ftobler/bldc-servo/README.md

# BLDC Servo

Custom PCB with BLDC controller for a Servo.

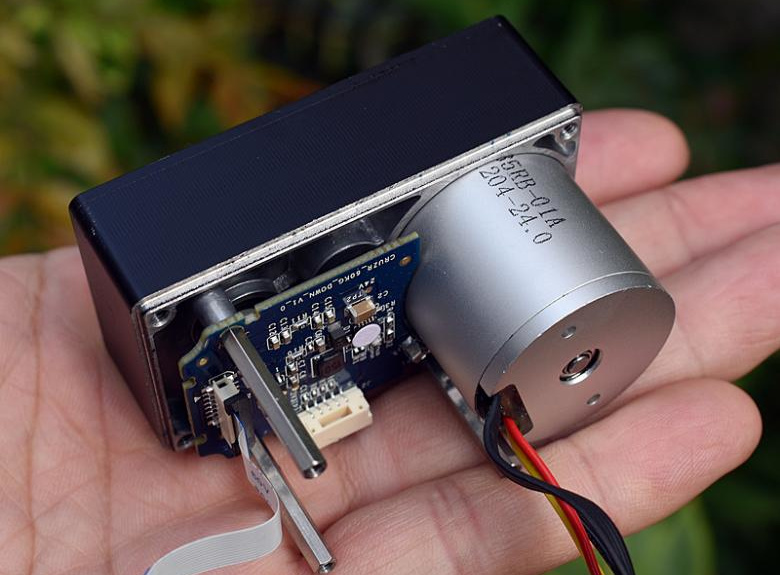
[picture p1: datasheet/aliexpress-Robot-precision-high-torque-60KG-bus-servo.jpg]
busservo
