ftobler/bldc-servo/datasheet/2835RB-motor-datasheet.jpg

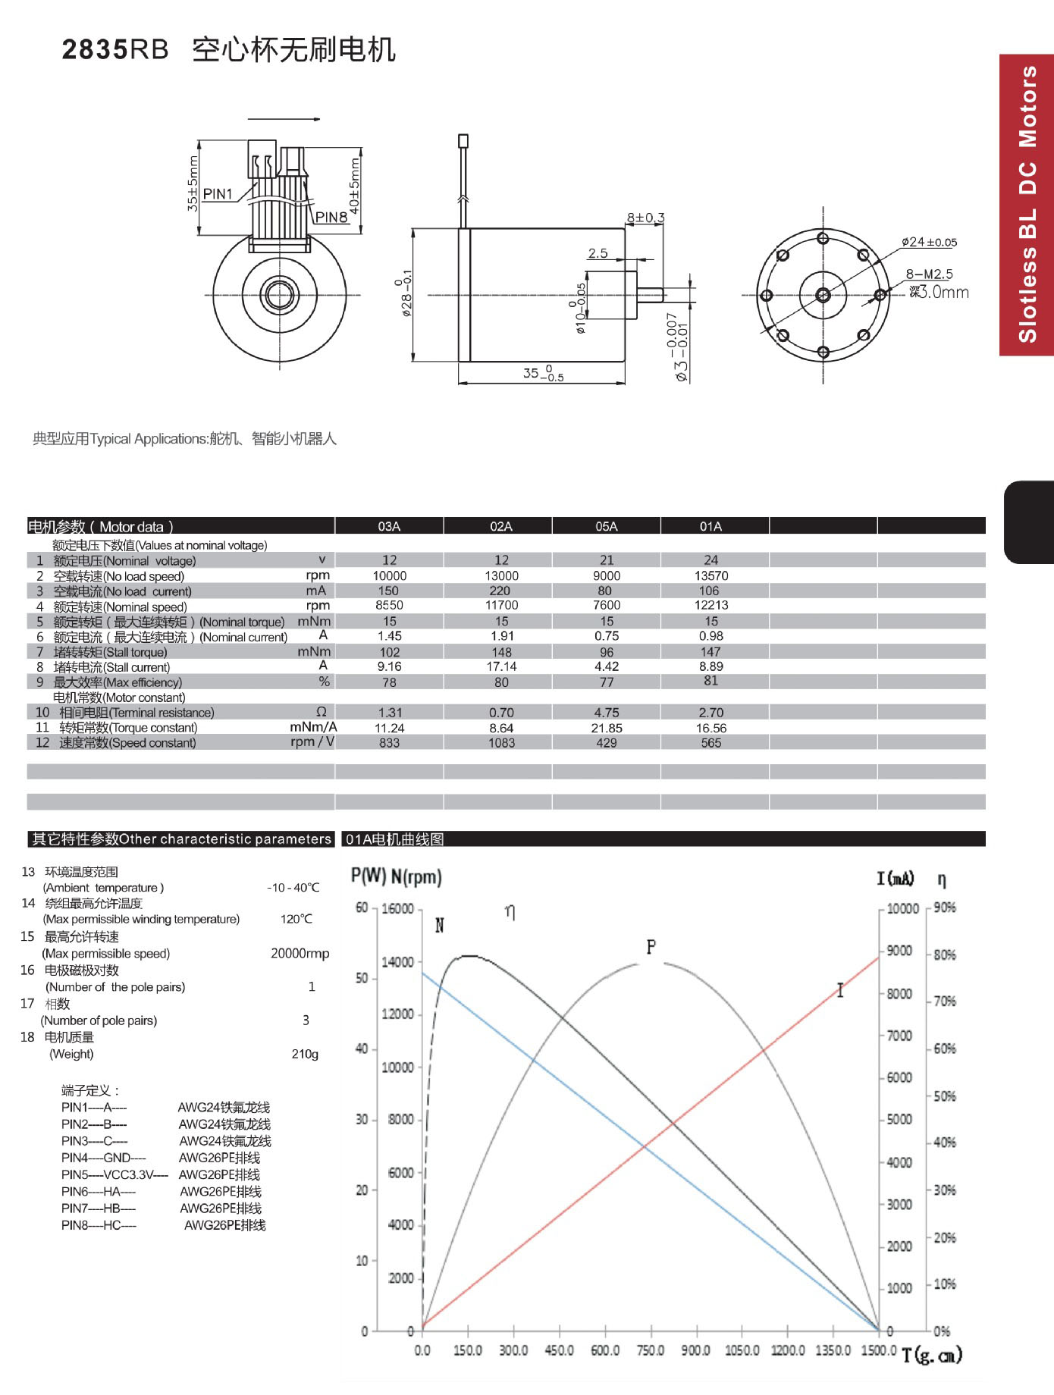
datasheet/2835RB-motor-datasheet.jpg
