ftobler/bldc-servo/datasheet/2835RB-motor.jpg

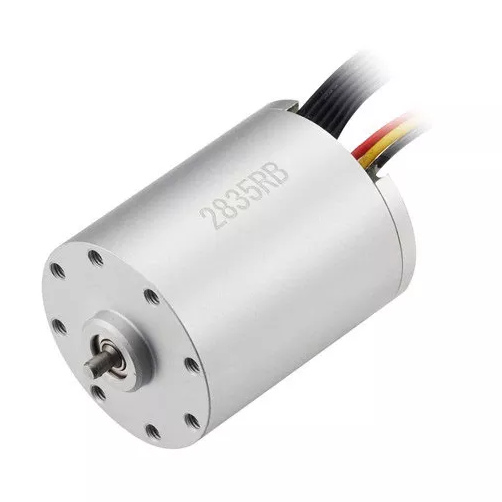
datasheet/2835RB-motor.jpg
