ftobler/bldc-servo/datasheet/bus-servo-bottom-pcb-projection.jpg

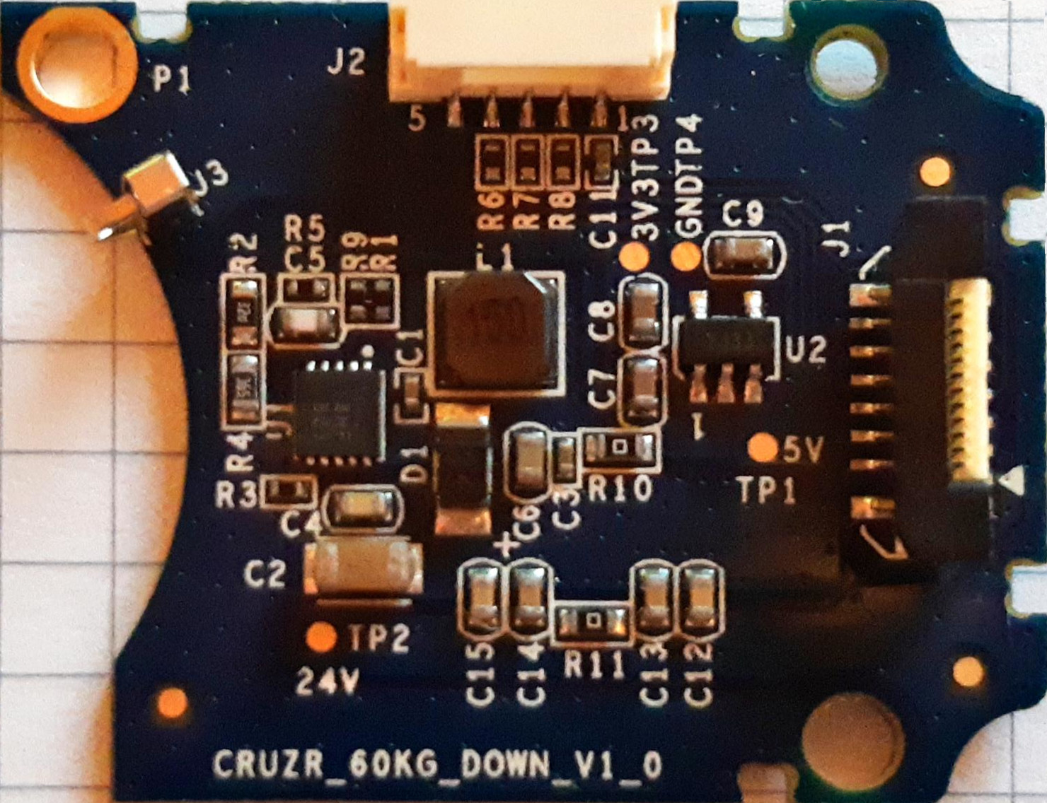
datasheet/bus-servo-bottom-pcb-projection.jpg
