ftobler/bldc-servo/datasheet/images_original_product/v2-01ab3820fb37335d740b385a8f822a2c_r.jpg

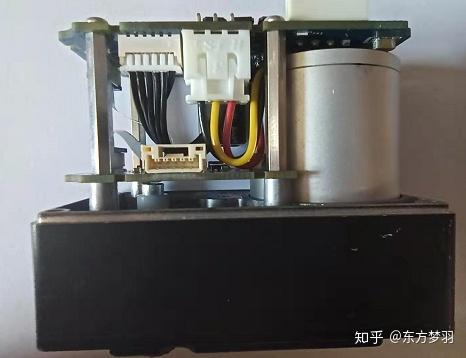
datasheet/images_original_product/v2-01ab3820fb37335d740b385a8f822a2c_r.jpg
