ftobler/bldc-servo/datasheet/images_original_product/v2-6b4d993ac4c0aa284fdc3b35ce2c8c43_r.jpg

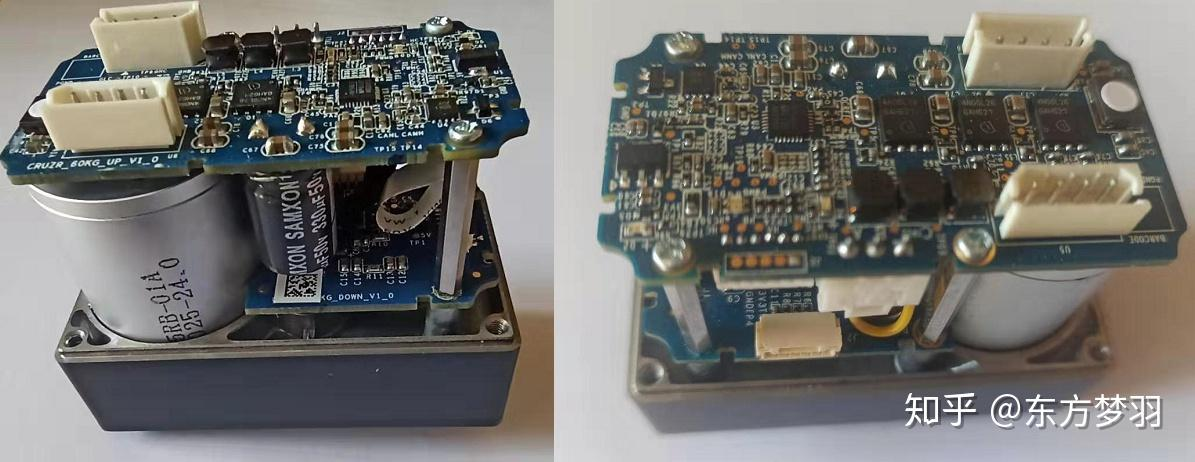
datasheet/images_original_product/v2-6b4d993ac4c0aa284fdc3b35ce2c8c43_r.jpg
