ftobler/bldc-servo/datasheet/images_original_product/v2-b16f528812346f2a6e2441583e27468b_r.jpg

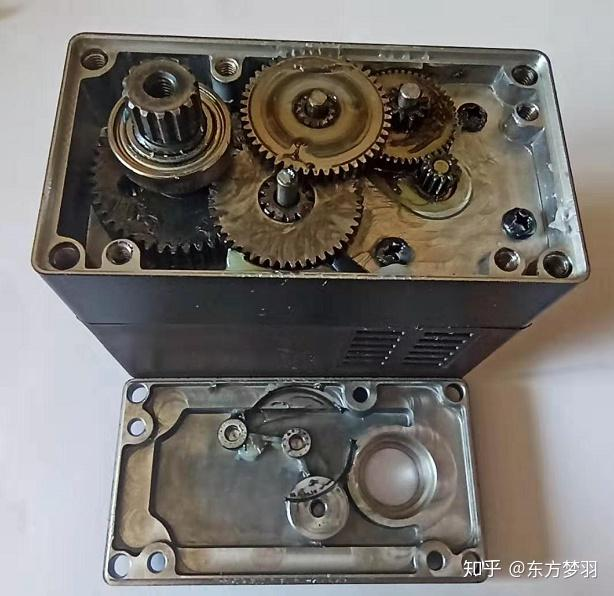
datasheet/images_original_product/v2-b16f528812346f2a6e2441583e27468b_r.jpg
