ftobler/bldc-servo/pcb/pcb-bldc-servo-2/servo pcb.dxf

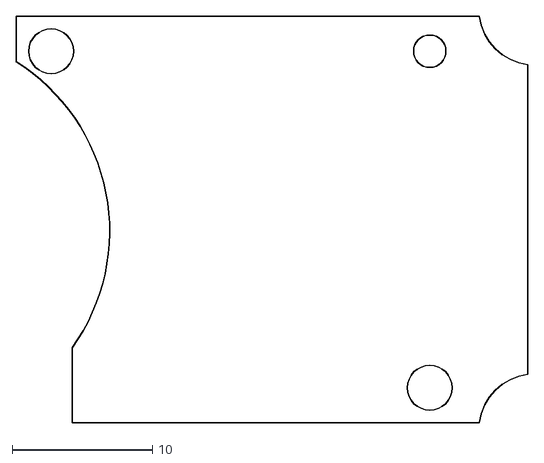
[picture p8: CAD file, 2022-09-07]
pcb/pcb-bldc-servo-2/servo pcb.dxf
36.5 x 29.0
