ftobler/bldc-servo/pcb/pcb-bldc-servo/pcb-bldc.step

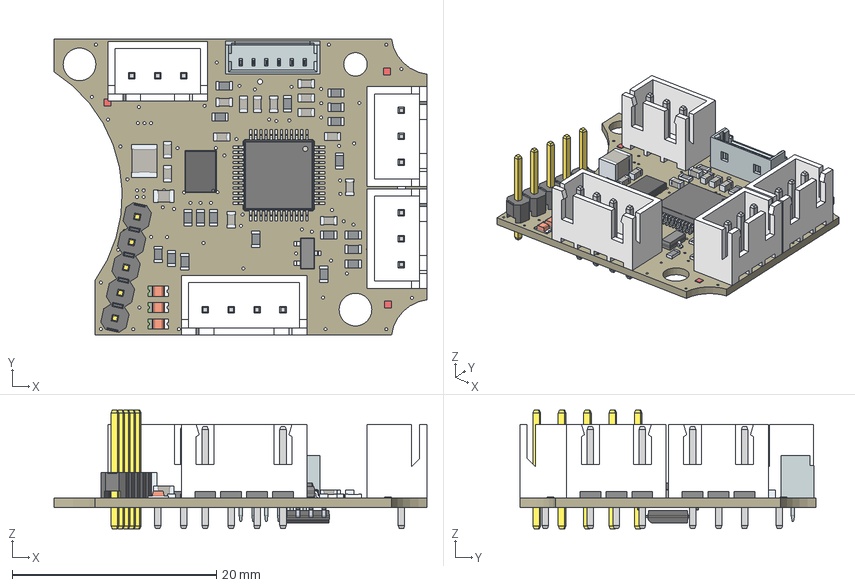
[picture p9: CAD file, 2022-09-07]
pcb/pcb-bldc-servo/pcb-bldc.step
36.5 x 29.0 x 11.6 mm
Board
4k7 x 19
10n x 14
PIN_5X1HD
MMBT2222
03-JST-B3B-XH-A x 3
MP6543H
4u7
47u
04-JST-B4B-XH-A
PIN_6X1
LED-0805 x 3
Package_SOIC-8_3
Package_SOIC-8_3 (1)
Package_SOIC-8_3 (2)
Package_SOIC-8_3 (3)
Package_SOIC-8_3 (4)
FIDUCIAL2MM x 4
