ftobler/bldc-servo/pcb/pcb-bldc-servo/pcb-bldc-servo.dxf

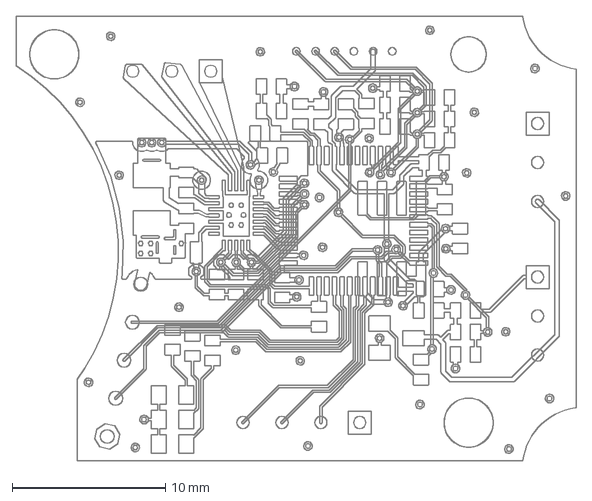
[picture p10: CAD file, 2022-09-07]
pcb/pcb-bldc-servo/pcb-bldc-servo.dxf
36.5 x 29.0 mm
