ftobler/bldc-servo/pcb/pcb-bldc-servo-4/pcb-bldc-servo-4.pdf

# GND ⁺³V³

# GND ¹⁰u VCC

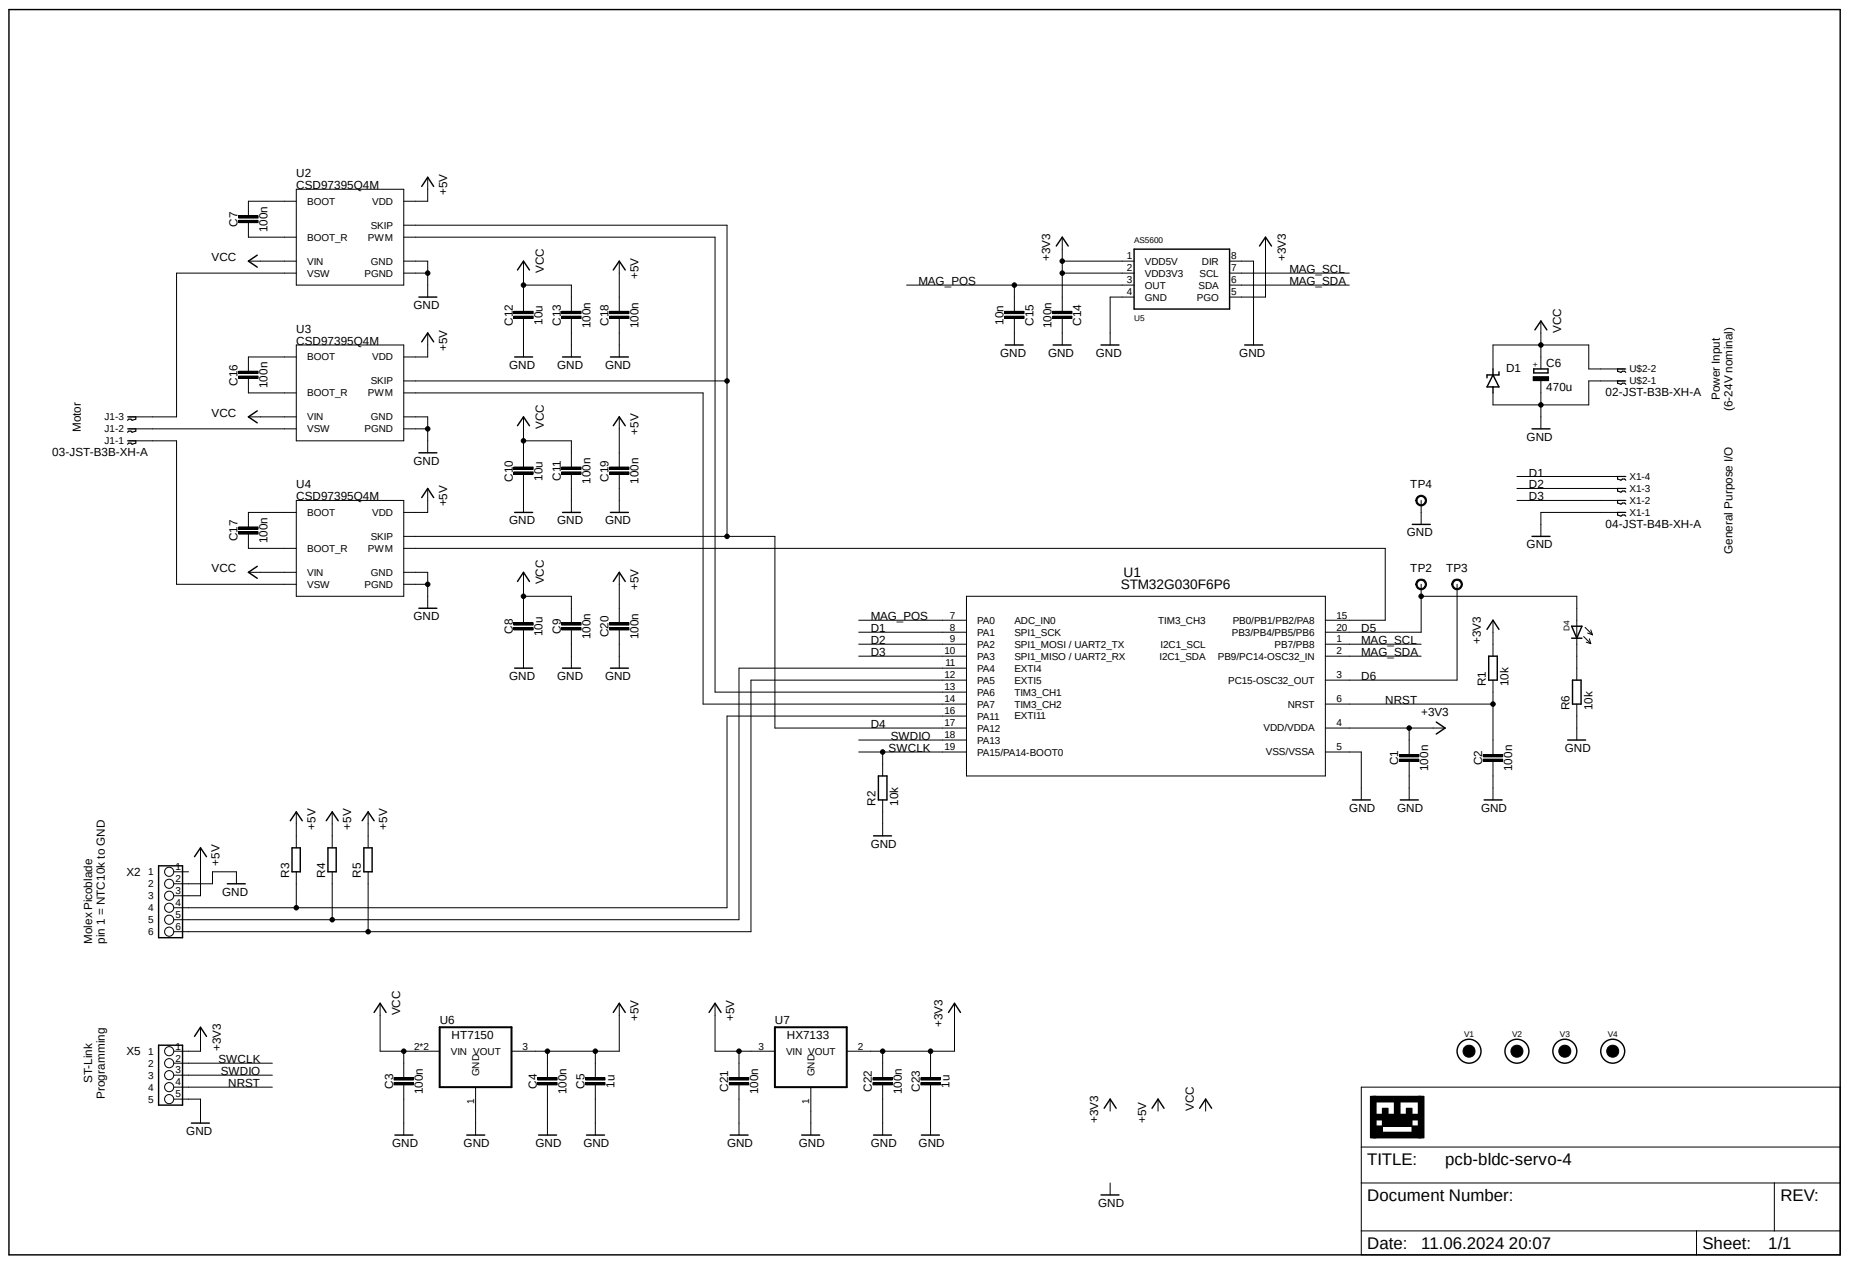
[picture p11: page 1]

GND +3V³

Document Number: | REV:

Date: 11.06.2024 20:07 | Sheet: 1/1
