ftobler/bldc-servo/pcb/pcb-bldc-servo-3/pcb-bldc-servo-3.pdf

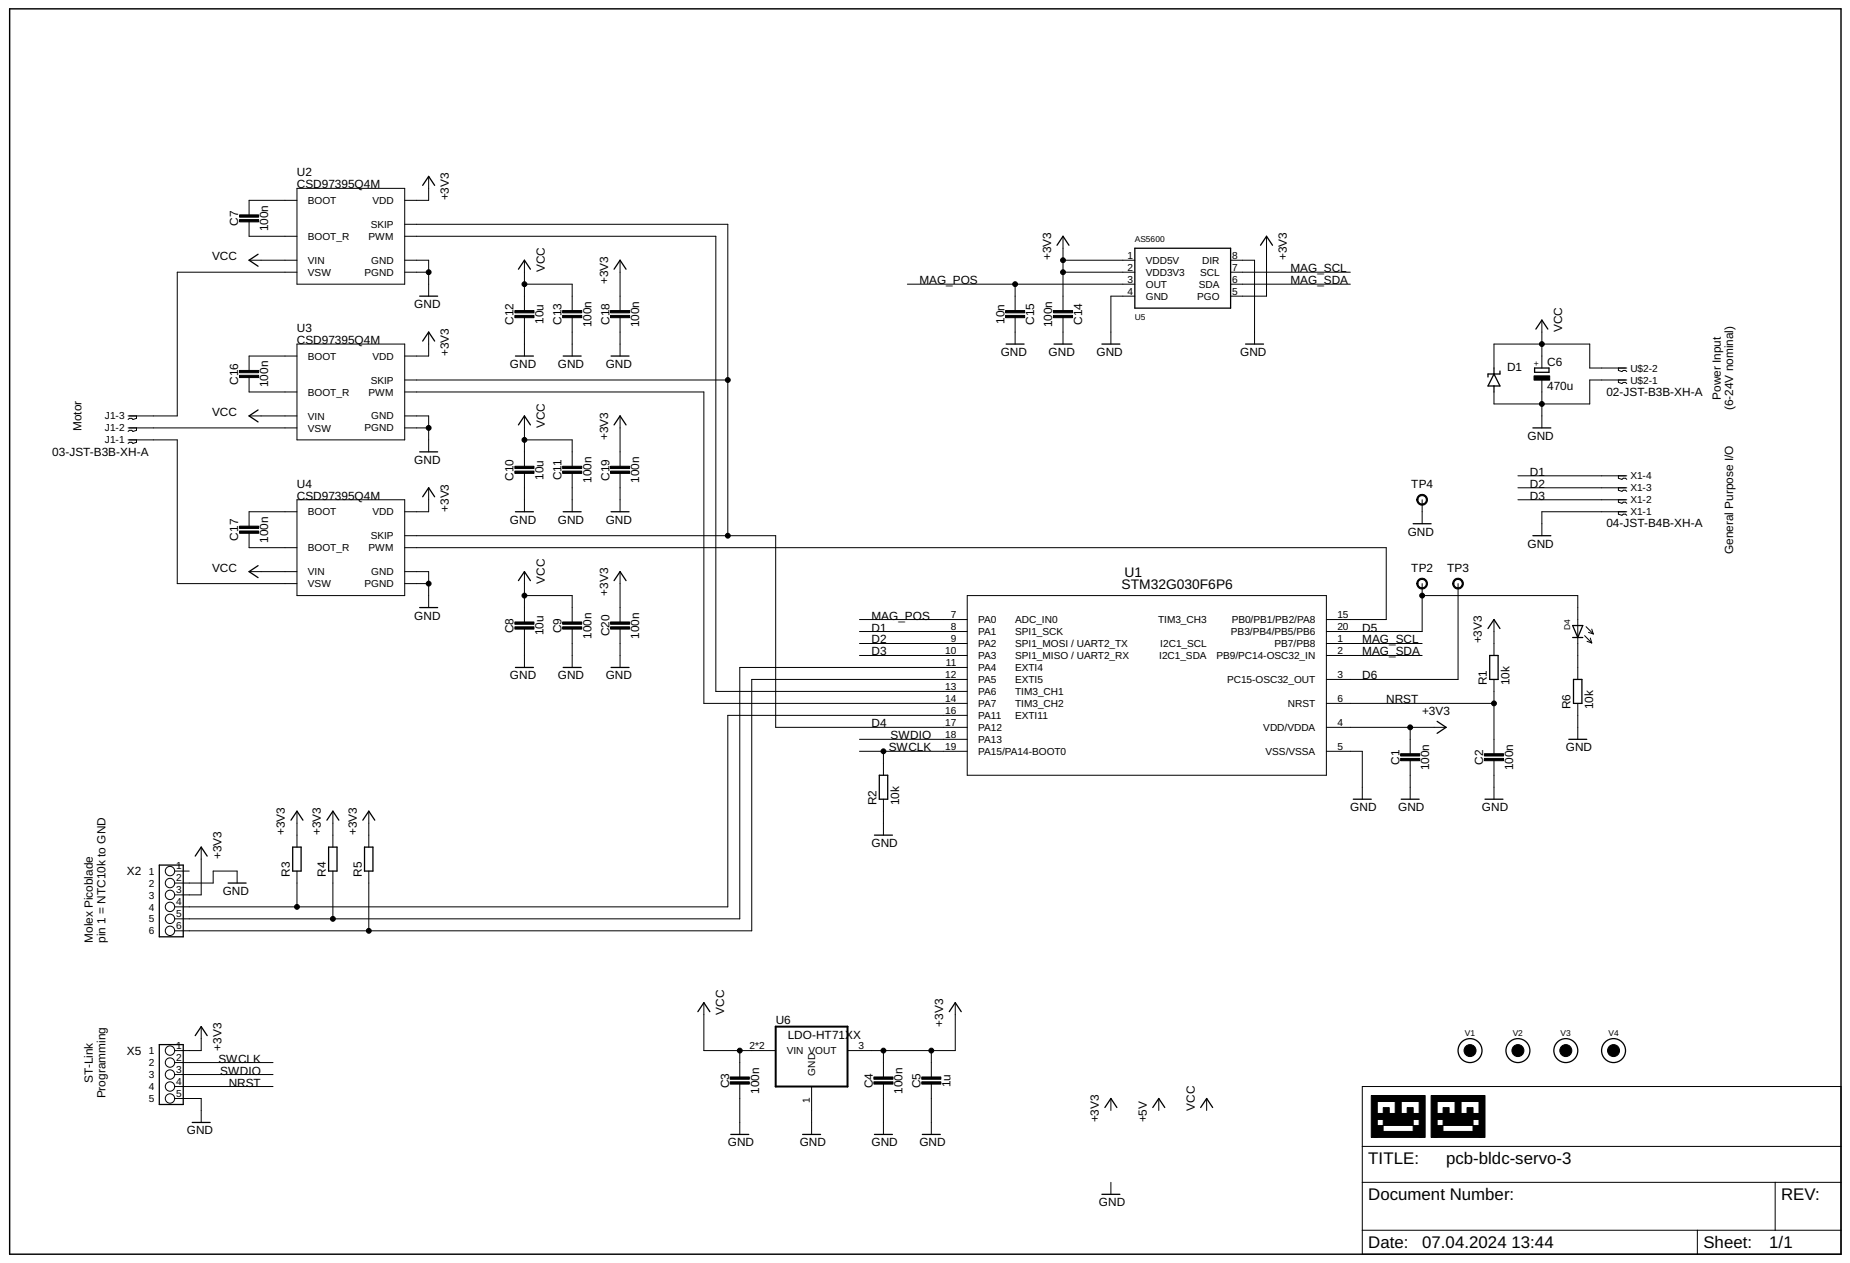
[picture p12: page 1]

ST-Link Programming Motor
