ftobler/bldc-servo/pcb/pcb-bldc-servo-4/pcb-bldc-servo-4.brd

## EAGLE design pcb/pcb-bldc-servo-4/pcb-bldc-servo-4.brd (2024-06-11)

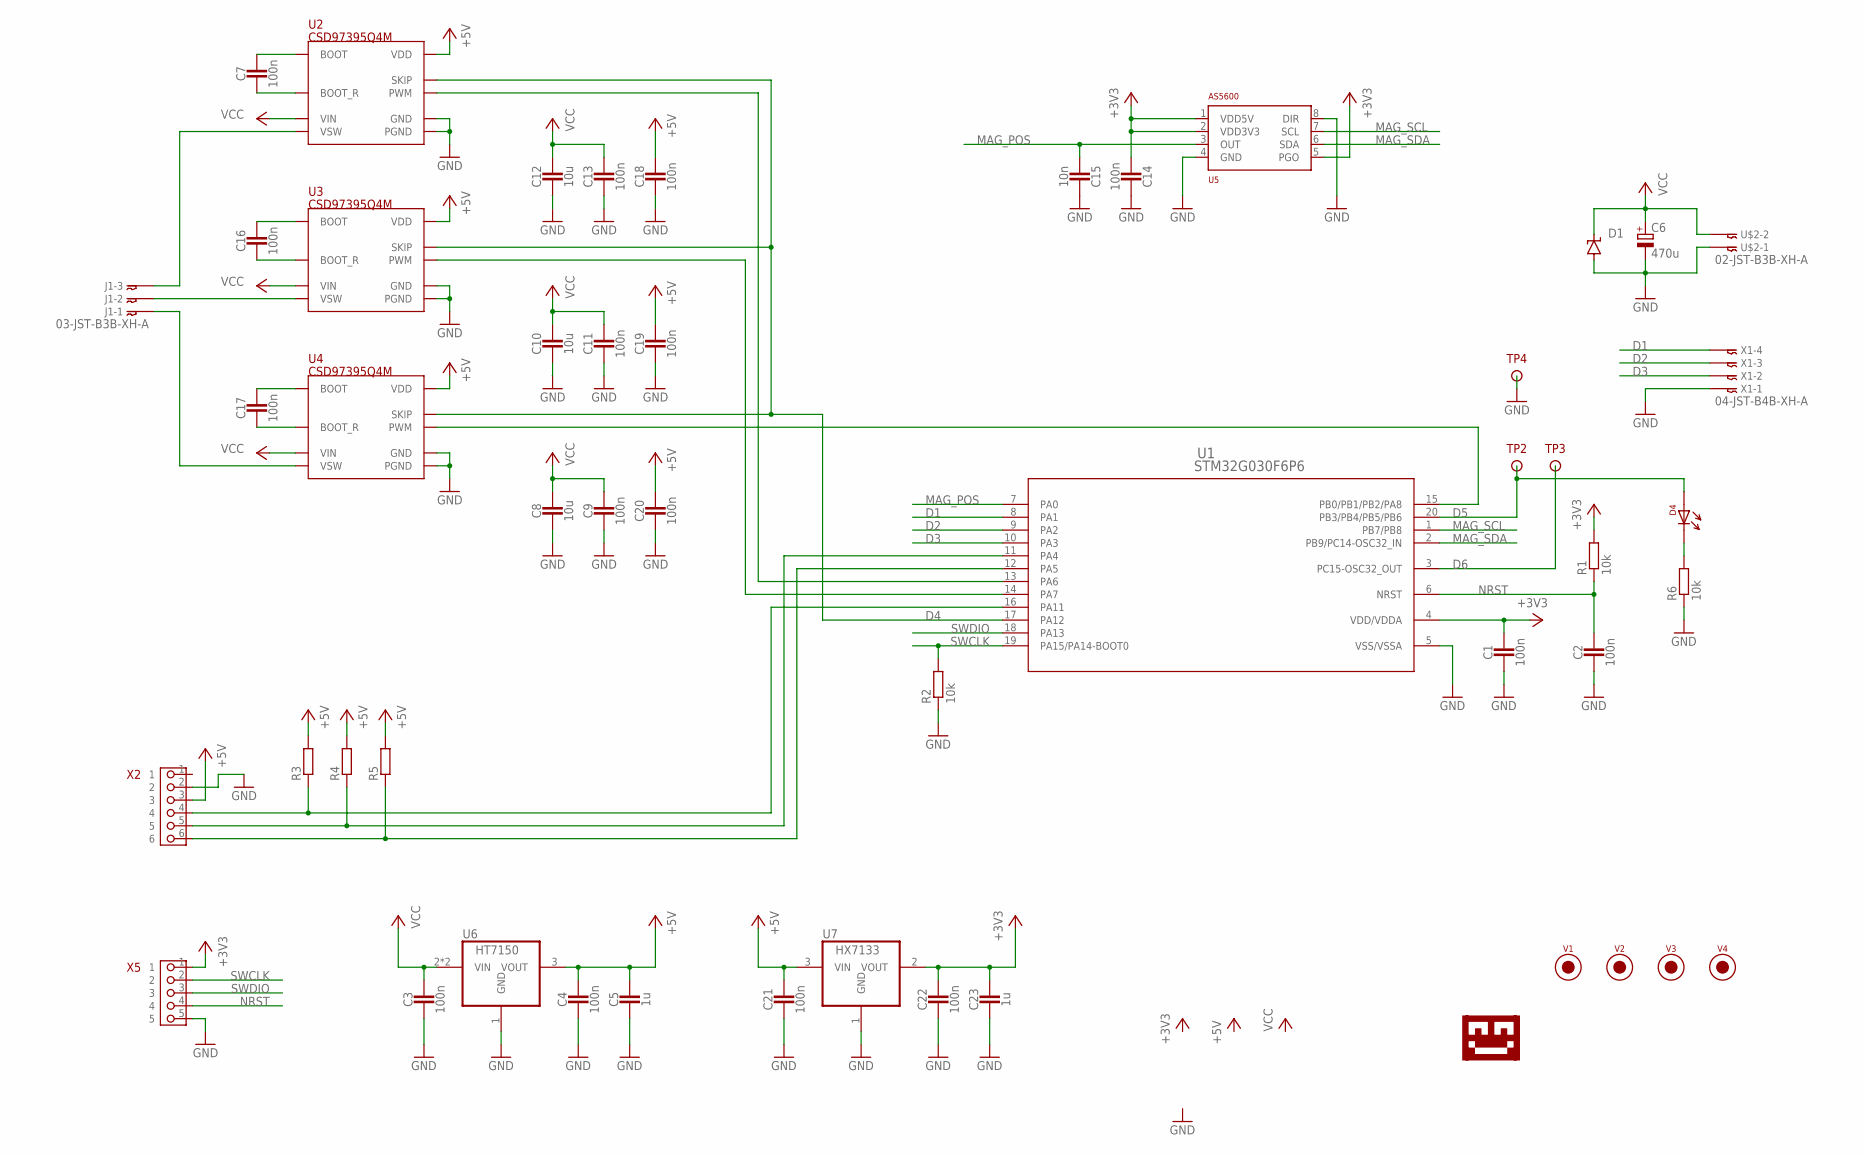
[picture p13: schematic pcb-bldc-servo-4.sch]

Parts:
C1, C2, C3, C4, C7, C9, C11, C13, C14, C16, C17, C18, C19, C20, C21, C22: 100n; 0603_CAP
C5, C23: 1u; 0603_CAP
C6: 470u; 153CLV-1010
C8, C10, C12: 10u; 1206_CAP
C15: 10n; 0603_CAP
D1: SUPPRESSOR-SMBJ; SMBJ
D4: LED-0805; 0805-DOT
J1: 03-JST-B3B-XH-A; B3B-XH
R1, R2, R6: 10k; 0603-RES
R3, R4, R5: RESISTOR0603_RES; 0603-RES
TP2, TP3, TP4: TESTPIN1MM; PIN-SMD-1X1-TEST_1M0
U1: STM32G030F6P6; TSSOP20
U2, U3, U4: CSD97395Q4M
U5: AS5600; SOIC-8
U6: HT7150; SOT-89
U7: HX7133; SOT-23
U$1: LOGO-TOBENG-1MM-FINISH; TOBENG-1MM-FINISH
U$2: 02-JST-B3B-XH-A; B2B-XH
V1, V2, V3, V4: FIDUCIAL2MM; FIDUCIAL_2MM
X1: 04-JST-B4B-XH-A; B4B-XH
X2: PIN_6X1; PIN_6X1_MOLEX_PICOBLADE
X5: PIN_5X1HD; PIN_5X1_HD

Connections:
+3V3: C1.1, C14.1, C22.1, C23.1, R1.2, U1.4 (VDD/VDDA), U5.1 (VDD5V), U5.2 (VDD3V3), U5.5 (PGO), U7.2 (VOUT), X5.1
+5V: C4.1, C5.1, C18.1, C19.1, C20.1, C21.1, R3.2, R4.2, R5.2, U2.VDD, U2.VDD1 (VDD), U3.VDD, U3.VDD1 (VDD), U4.VDD, U4.VDD1 (VDD), U6.3 (VOUT), U7.3 (VIN), X2.3
D1: U1.8 (PA1), X1.P$4
D2: U1.9 (PA2), X1.P$3
D3: U1.10 (PA3), X1.P$2
D4: U1.17 (PA12), U2.SKIP, U2.SKIP1 (SKIP), U3.SKIP, U3.SKIP1 (SKIP), U4.SKIP, U4.SKIP1 (SKIP)
D5: D4.1, TP2.1, U1.20 (PB3/PB4/PB5/PB6)
D6: TP3.1, U1.3 (PC15-OSC32_OUT)
GND: C1.2, C2.2, C3.2, C4.2, C5.2, C6.-, C8.2, C9.2, C10.2, C11.2, C12.2, C13.2, C14.2, C15.2, C18.2, C19.2, C20.2, C21.2, C22.2, C23.2, D1.A, R2.1, R6.1, TP4.1, U1.5 (VSS/VSSA), U2.GND, U2.GND1 (GND), U2.PGND, U3.GND, U3.GND1 (GND), U3.PGND, U4.GND, U4.GND1 (GND), U4.PGND, U5.4 (GND), U5.8 (DIR), U6.1 (GND), U7.1 (GND), U$2.P$1, X1.P$1, X2.2, X5.5
MAG_POS: C15.1, U1.7 (PA0), U5.3 (OUT)
MAG_SCL: U1.1 (PB7/PB8), U5.7 (SCL)
MAG_SDA: U1.2 (PB9/PC14-OSC32_IN), U5.6 (SDA)
unnamed: C7.1, U2.BOOT, U2.BOOT1 (BOOT)
unnamed: C7.2, U2.BOOT_R, U2.BOOT_R1 (BOOT_R)
unnamed: J1.P$2, U3.VSW, U3.VSW1 (VSW), U3.VSW2 (VSW), U3.VSW3 (VSW), U3.VSW4 (VSW), U3.VSW5 (VSW), U3.VSW6 (VSW)
unnamed: J1.P$3, U2.VSW, U2.VSW1 (VSW), U2.VSW2 (VSW), U2.VSW3 (VSW), U2.VSW4 (VSW), U2.VSW5 (VSW), U2.VSW6 (VSW)
unnamed: U1.13 (PA6), U2.PWM, U2.PWM1 (PWM)
unnamed: U1.14 (PA7), U3.PWM, U3.PWM1 (PWM)
unnamed: J1.P$1, U4.VSW, U4.VSW1 (VSW), U4.VSW2 (VSW), U4.VSW3 (VSW), U4.VSW4 (VSW), U4.VSW5 (VSW), U4.VSW6 (VSW)
unnamed: C16.1, U3.BOOT, U3.BOOT1 (BOOT)
unnamed: U1.15 (PB0/PB1/PB2/PA8), U4.PWM, U4.PWM1 (PWM)
unnamed: C16.2, U3.BOOT_R, U3.BOOT_R1 (BOOT_R)
unnamed: C17.1, U4.BOOT, U4.BOOT1 (BOOT)
unnamed: C17.2, U4.BOOT_R, U4.BOOT_R1 (BOOT_R)
unnamed: D4.2, R6.2
unnamed: R5.1, U1.12 (PA5), X2.6
unnamed: R4.1, U1.11 (PA4), X2.5
unnamed: R3.1, U1.16 (PA11), X2.4
NRST: C2.1, R1.1, U1.6 (NRST), X5.4
SWCLK: R2.2, U1.19 (PA15/PA14-BOOT0), X5.2
SWDIO: U1.18 (PA13), X5.3
VCC: C3.1, C6.+, C8.1, C9.1, C10.1, C11.1, C12.1, C13.1, D1.C, U2.VIN, U2.VIN1 (VIN), U2.VIN2 (VIN), U2.VIN3 (VIN), U2.VIN4 (VIN), U2.VIN5 (VIN), U2.VIN6 (VIN), U3.VIN, U3.VIN1 (VIN), U3.VIN2 (VIN), U3.VIN3 (VIN), U3.VIN4 (VIN), U3.VIN5 (VIN), U3.VIN6 (VIN), U4.VIN, U4.VIN1 (VIN), U4.VIN2 (VIN), U4.VIN3 (VIN), U4.VIN4 (VIN), U4.VIN5 (VIN), U4.VIN6 (VIN), U6.2 (VIN), U6.2@1 (VIN), U$2.P$2

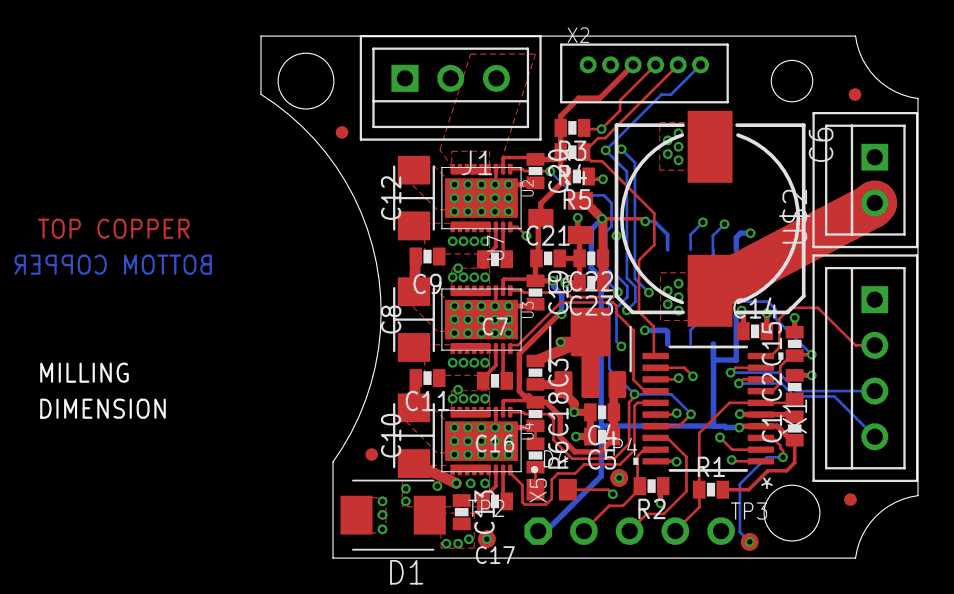
[picture p14: board pcb-bldc-servo-4.brd from above]

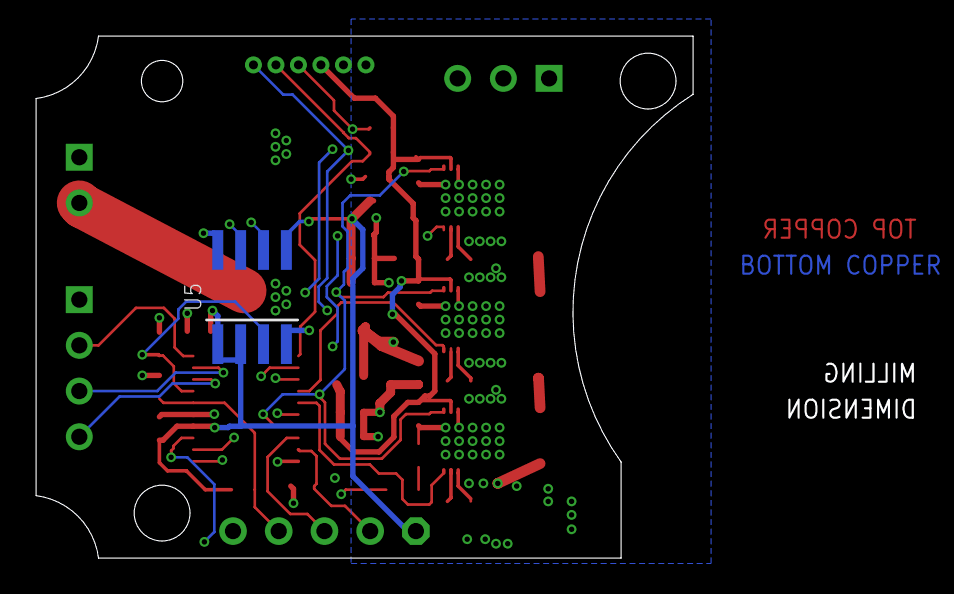
[picture p15: board pcb-bldc-servo-4.brd from below]

Board: 4 copper layers, 36.5 x 29.0 mm, 51 parts (2 on the bottom side), 32 nets.
