ftobler/bldc-servo/pcb/pcb-bldc-servo/pcb-bldc-servo.brd

## EAGLE design pcb/pcb-bldc-servo/pcb-bldc-servo.brd (2024-04-01)

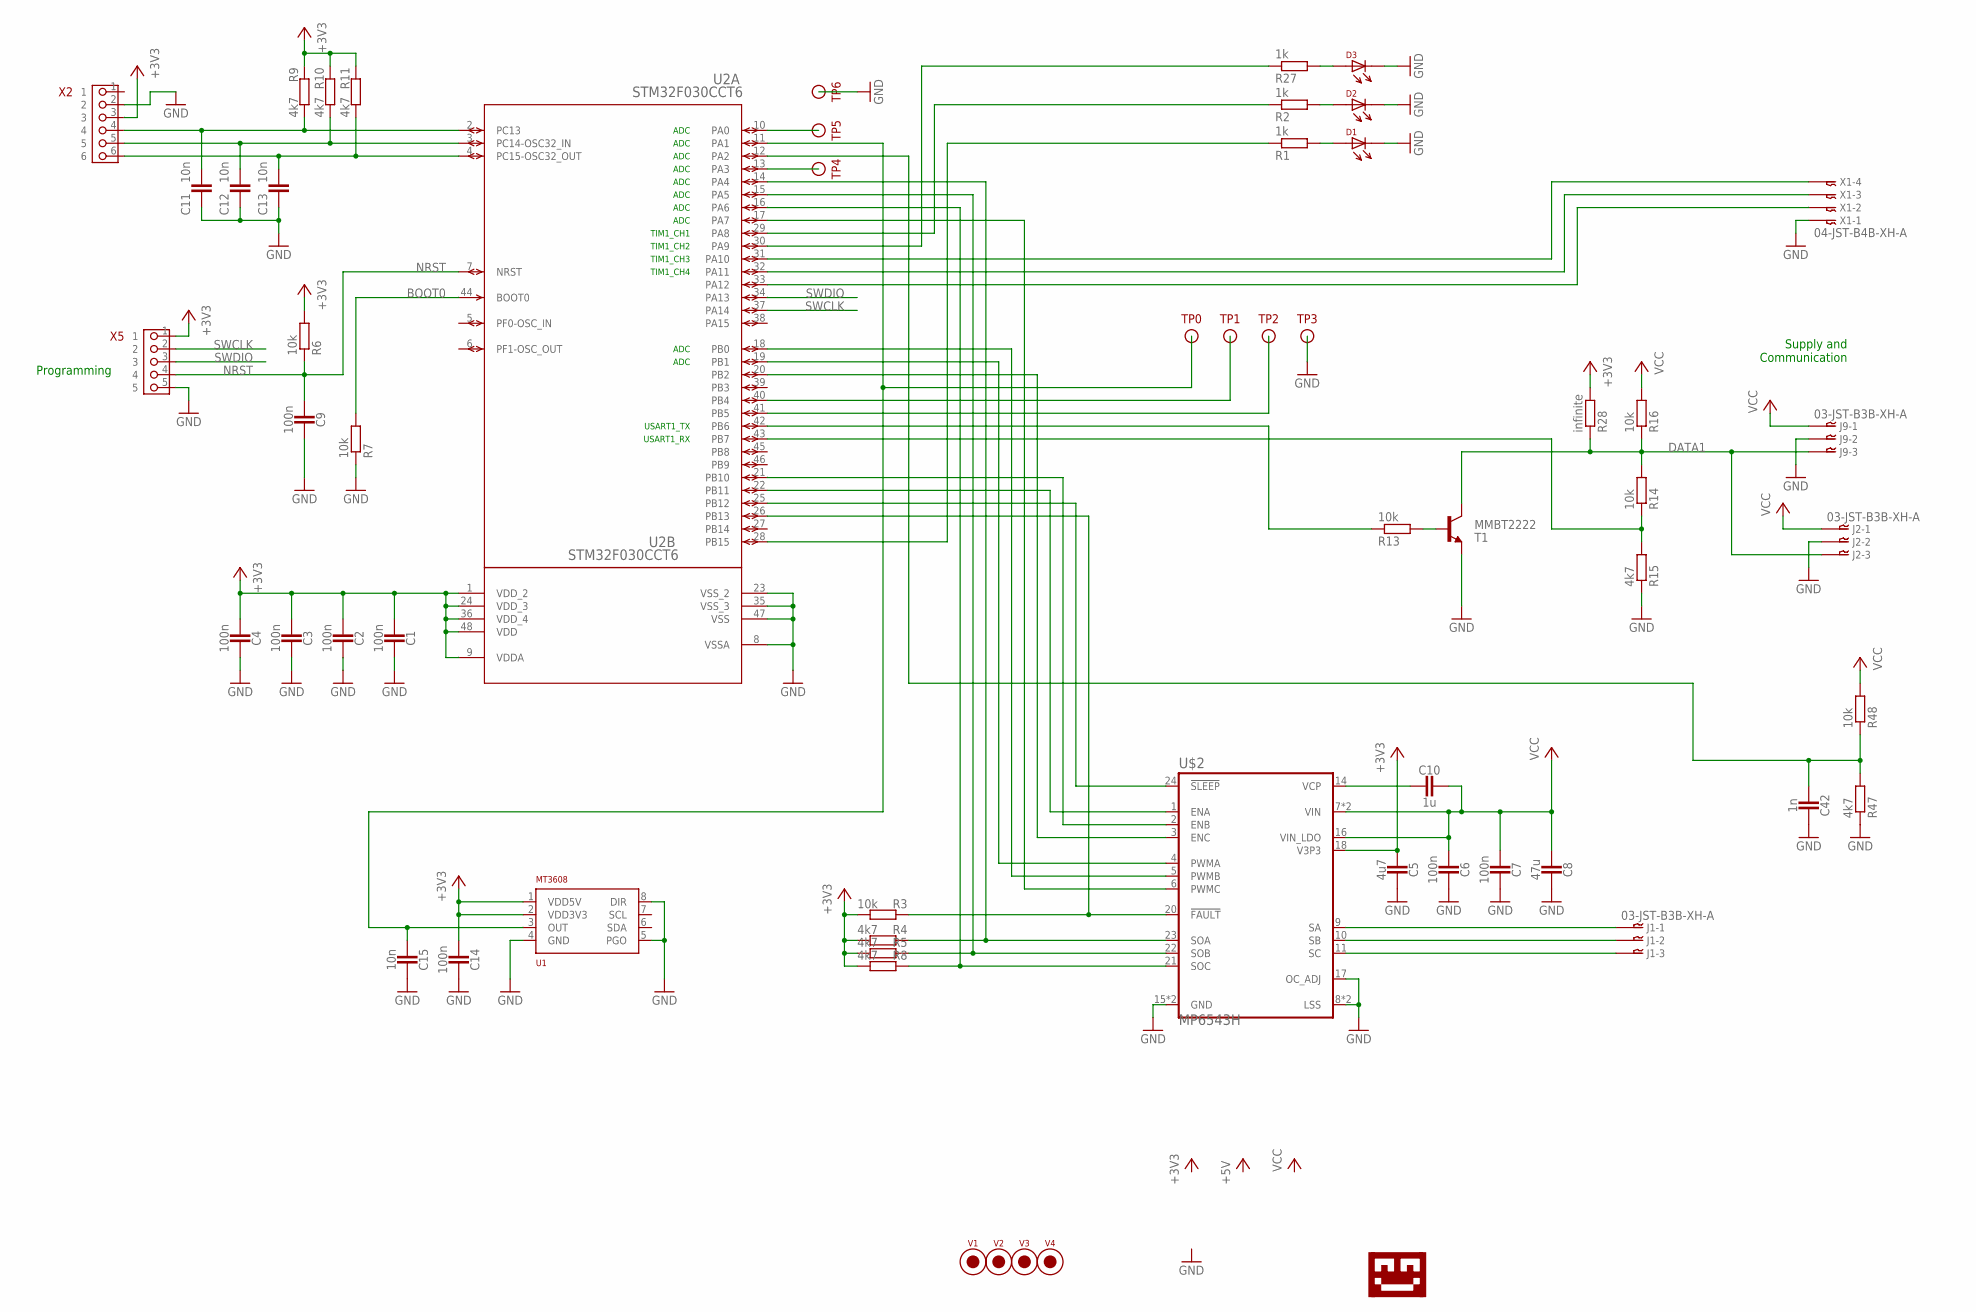
[picture p16: schematic pcb-bldc-servo.sch]

Parts:
C1, C2, C3, C4, C6, C7, C9, C14: 100n; 0603_CAP
C5: 4u7; 0805_CAP
C8: 47u; 1210_CAP
C10: 1u; 0603_CAP
C11, C12, C13, C15: 10n; 0603_CAP
C42: 1n; 0603_CAP
D1, D2, D3: LED-0805; 0805-DOT
J1, J2, J9: 03-JST-B3B-XH-A; B3B-XH
R1, R2, R27: 1k; 0603-RES
R3, R6, R7, R13, R14, R16, R48: 10k; 0603-RES
R4, R5, R8, R9, R10, R11, R15, R47: 4k7; 0603-RES
R28: infinite; 0603-RES
T1: MMBT2222; SOT23-BEC
TP0, TP1, TP2, TP3, TP4, TP5, TP6: TESTPIN; PIN-SMD-1X1-TEST_1M5
U1: AS5600; SOIC-8
U2: STM32F030CCT6; LQFP48-7X7MM
U$1: LOGO-TOBENG-1MM-FINISH; TOBENG-1MM-FINISH
U$2: MP6543H; QFN24
V1, V2, V3, V4: FIDUCIAL2MM; FIDUCIAL_2MM
X1: 04-JST-B4B-XH-A; B4B-XH
X2: PIN_6X1; PIN_6X1_MOLEX_PICOBLADE
X5: PIN_5X1HD; PIN_5X1_HD

Connections:
+3V3: C1.1, C2.1, C3.1, C4.1, C5.P$1 (1), C14.1, R3.2, R4.2, R5.2, R6.2, R8.2, R9.1, R10.1, R11.1, R28.2, U1.1 (VDD5V), U1.2 (VDD3V3), U2.1 (VDD_2), U2.9 (VDDA), U2.24 (VDD_3), U2.36 (VDD_4), U2.48 (VDD), U$2.18 (V3P3), X2.3, X5.1
BOOT0: R7.2, U2.44 (BOOT0)
DATA1: J2.P$3, J9.P$3, R14.2, R16.1, R28.1, T1.C
GND: C1.2, C2.2, C3.2, C4.2, C5.P$2 (2), C6.2, C7.2, C8.2, C9.2, C11.2, C12.2, C13.2, C14.2, C15.2, C42.2, D1.2, D2.2, D3.2, J2.P$2, J9.P$2, R7.1, R15.1, R47.1, T1.E, TP3.1, TP6.1, U1.4 (GND), U1.5 (PGO), U1.8 (DIR), U2.8 (VSSA), U2.23 (VSS_2), U2.35 (VSS_3), U2.47 (VSS), U$2.8 (LSS), U$2.12 (LSS), U$2.15 (GND), U$2.17 (OC_ADJ), U$2.25 (GND), X1.P$1, X2.2, X5.5
M3B1: C42.1, R47.2, R48.1, U2.12 (PA2)
unnamed: U2.20 (PB2), U$2.3 (ENC)
unnamed: U2.21 (PB10), U$2.2 (ENB)
unnamed: U2.22 (PB11), U$2.1 (ENA)
unnamed: D1.1, R1.2
unnamed: U2.17 (PA7), U$2.6 (PWMC)
unnamed: U2.18 (PB0), U$2.5 (PWMB)
unnamed: D2.1, R2.2
unnamed: R27.1, U2.30 (PA9)
unnamed: U2.19 (PB1), U$2.4 (PWMA)
unnamed: R2.1, U2.29 (PA8)
unnamed: D3.1, R27.2
unnamed: R13.1, U2.42 (PB6)
unnamed: R14.1, R15.2, U2.43 (PB7)
unnamed: R13.2, T1.B
unnamed: J1.P$1, U$2.9 (SA)
unnamed: J1.P$2, U$2.10 (SB)
unnamed: J1.P$3, U$2.11 (SC)
unnamed: R8.1, U2.16 (PA6), U$2.21 (SOC)
unnamed: R5.1, U2.15 (PA5), U$2.22 (SOB)
unnamed: R4.1, U2.14 (PA4), U$2.23 (SOA)
unnamed: U2.25 (PB12), U$2.24 (!SLEEP)
unnamed: R3.1, U2.26 (PB13), U$2.20 (!FAULT)
unnamed: U2.33 (PA12), X1.P$2
unnamed: C13.1, R11.2, U2.4 (PC15-OSC32_OUT), X2.6
unnamed: C12.1, R10.2, U2.3 (PC14-OSC32_IN), X2.5
unnamed: R1.1, U2.28 (PB15)
unnamed: C10.1, U$2.14 (VCP)
unnamed: C11.1, R9.2, U2.2 (PC13), X2.4
unnamed: U2.32 (PA11), X1.P$3
unnamed: U2.31 (PA10), X1.P$4
unnamed: TP1.1, U2.40 (PB4)
unnamed: C15.1, TP0.1, U1.3 (OUT), U2.11 (PA1)
unnamed: TP2.1, U2.41 (PB5)
unnamed: TP4.1, U2.13 (PA3)
unnamed: TP5.1, U2.10 (PA0)
NRST: C9.1, R6.1, U2.7 (NRST), X5.4
SWCLK: U2.37 (PA14), X5.2
SWDIO: U2.34 (PA13), X5.3
VCC: C6.1, C7.1, C8.1, C10.2, J2.P$1, J9.P$1, R16.2, R48.2, U$2.7 (VIN), U$2.13 (VIN), U$2.16 (VIN_LDO)

Notes on the sheet:
Programming
ADC
TIM1_CH1
TIM1_CH2
TIM1_CH3
TIM1_CH4
USART1_RX
USART1_TX
Supply and Communication

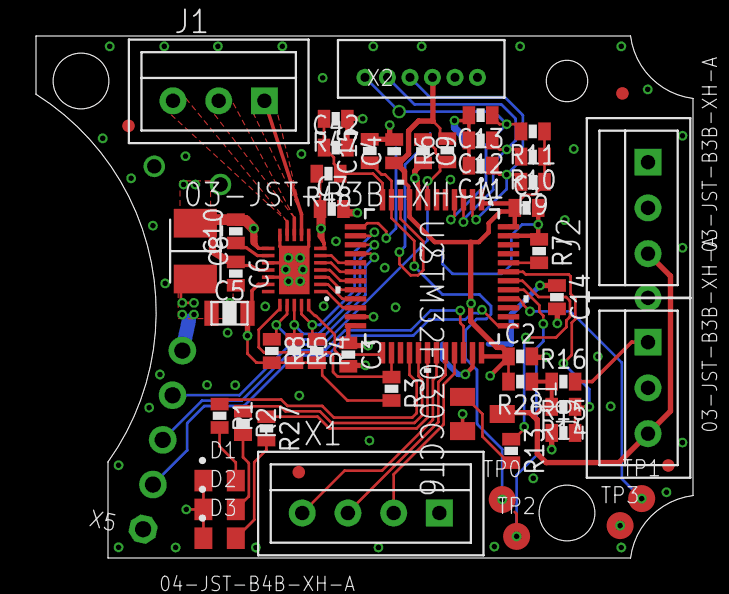
[picture p17: board pcb-bldc-servo.brd from above]

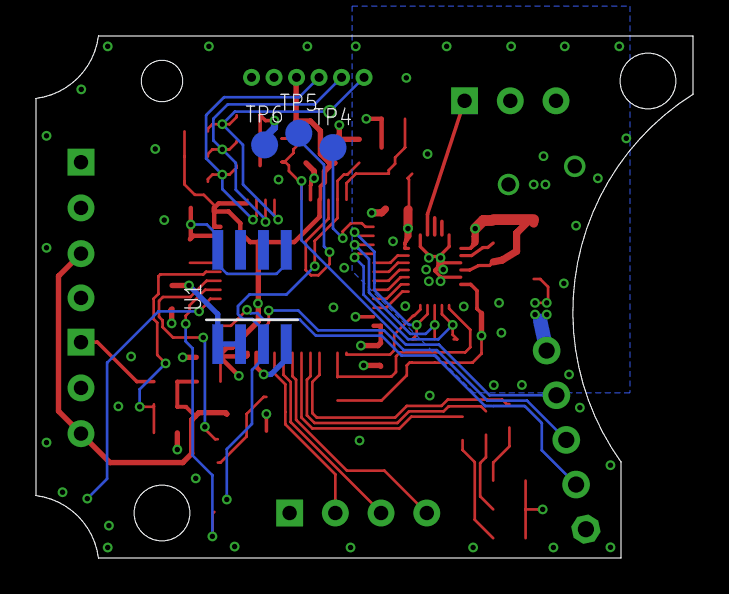
[picture p18: board pcb-bldc-servo.brd from below]

Board: 4 copper layers, 36.5 x 29.0 mm, 60 parts (5 on the bottom side), 44 nets.
