ftobler/bldc-servo/stm-bldc-servo/stm-bldc-servo.ioc

Mcu.UserName=STM32G030F6Px
PA0.GPIO_Label=ADC1_IN0_MAG_POS
PA0.Signal=ADC1_IN0
PA13.Signal=SYS_SWDIO
PA14-BOOT0.Signal=SYS_SWCLK
PA2.Signal=USART2_TX
PA3.Signal=USART2_RX
PA4.GPIO_Label=SENS3
PA4.Signal=GPIO_Input
PA5.GPIO_Label=SENS2
PA5.Signal=GPIO_Input
PA6.Signal=S_TIM3_CH1
PA7.Signal=S_TIM3_CH2
PB0.Signal=S_TIM3_CH3
PB3.GPIO_Label=LED
PB3.Signal=GPIO_Output
PB8.Signal=I2C1_SCL
PB9.Signal=I2C1_SDA
