ftobler/bldc-servo/stm-bldc-servo/Core/Inc/main.h

#define ADC1_IN0_MAG_POS_Pin GPIO_PIN_0
#define ADC1_IN0_MAG_POS_GPIO_Port GPIOA
#define SENS3_Pin GPIO_PIN_4
#define SENS3_GPIO_Port GPIOA
#define SENS2_Pin GPIO_PIN_5
#define SENS2_GPIO_Port GPIOA
#define SENS1_Pin GPIO_PIN_11
#define SENS1_GPIO_Port GPIOA
#define SKIP_Pin GPIO_PIN_12
#define SKIP_GPIO_Port GPIOA
#define LED_Pin GPIO_PIN_3
#define LED_GPIO_Port GPIOB
