ftobler/bldc-servo/stm-bldc-servo/application/application.h

/*
 * application.h
 *
 *  Created on: Apr 17, 2024
 *      Author: ftobler
 */

#ifndef APPLICATION_H_
#define APPLICATION_H_

#ifdef __cplusplus
extern "C" {
#endif

void application_setup();
void application_loop();
void control_loop();

#ifdef __cplusplus
}
#endif

#endif /* APPLICATION_H_ */
