ftobler/bldc-servo/stm-bldc-servo/application/as5600.h

/*
 * as5600.h
 *
 *  Created on: Apr 19, 2024
 *      Author: ftobler
 */

#ifndef AS5600_H_
#define AS5600_H_

#ifdef __cplusplus
extern "C" {
#endif


void as5600_poll();


#ifdef __cplusplus
}
#endif

#endif /* AS5600_H_ */
