ftobler/bldc-servo/stm-bldc-servo/application/stm32_hal.h

/*
 * stm32hal.h
 *
 *  Created on: Apr 17, 2024
 *      Author: ftobler
 */

#ifndef STM32_HAL_H_
#define STM32_HAL_H_

#ifdef __cplusplus
extern "C" {
#endif

#include "stm32g0xx.h"
#include "stm32g0xx_hal.h"

#ifdef __cplusplus
}
#endif

#endif /* STM32_HAL_H_ */
