ftobler/bldc-servo/(commit log)

2022-09-07 pcb outline
    [pcb-bldc-servo.dxf]
2022-09-07 eagle pcbs
    [pcb-bldc-servo.brd, pcb-bldc-servo.sch]
2022-09-07 step file
    [pcb-bldc.step]
2022-09-08 updated gerber
    [pcb-bldc-servo.brd, pcb-bldc-servo.sch]
2024-04-01 updated schematic for correct sensor cable
    [pcb-bldc-servo.brd, pcb-bldc-servo.sch]
2024-04-01 motor datasheet
2024-04-01 redesign with new driver
    [pcb-bldc-servo-2.brd, pcb-bldc-servo-2.sch, servo pcb.dxf]
2024-04-02 sensor datasheet
2024-04-02 small fixes
    [pcb-bldc-servo-2.brd, pcb-bldc-servo-2.sch]
2024-04-02 board revision 3
    [pcb-bldc-servo-3.brd, pcb-bldc-servo-3.sch, servo pcb.dxf]
2024-04-17 pcb v3 as ordered - moved to pcb folder
    [pcb-bldc-servo-2.brd, pcb-bldc-servo-2.sch, pcb-bldc-servo-3.brd, pcb-bldc-servo-3.sch, pcb-bldc-servo.brd, pcb-bldc-servo.dxf, pcb-bldc-servo.sch, pcb-bldc.step]
2024-04-17 stm32 project with new processor
2024-04-17 datasheet of driver
2024-04-18 cleanup / control loop / pwm to 20kHz
2024-04-19 i2c sensor, modbus
2024-05-10 second LDO for 3.3 and 5V separate
    [pcb-bldc-servo-4.brd, pcb-bldc-servo-4.sch, servo pcb.dxf]
2024-06-11 pcb release v4
    [pcb-bldc-servo-4.brd, pcb-bldc-servo-4.sch]
